tigran-abgaryan/window-opener/pcb_back_56x29_337dpi.png

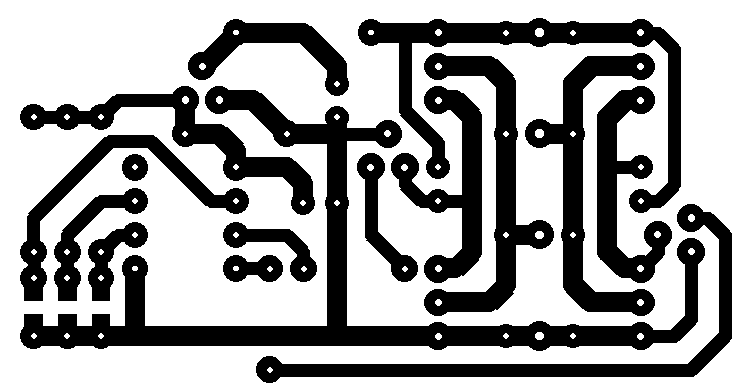
pcb_back_56x29_337dpi.png
