tigran-abgaryan/window-opener/pcb_front_56x29_337dpi.png

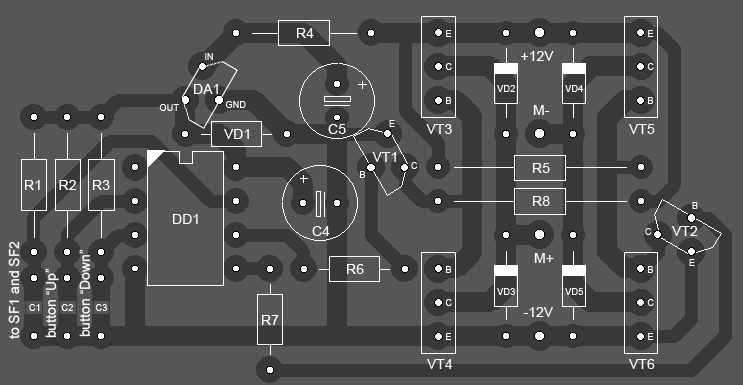
pcb_front_56x29_337dpi.png
