tigran-abgaryan/window-opener/(list of files, drawings)

Other design files:
pcb.lay
